kosmop0lit/Pitot_tube_telemetry/media/photo_6_2026-10-28_22-49-24.jpg

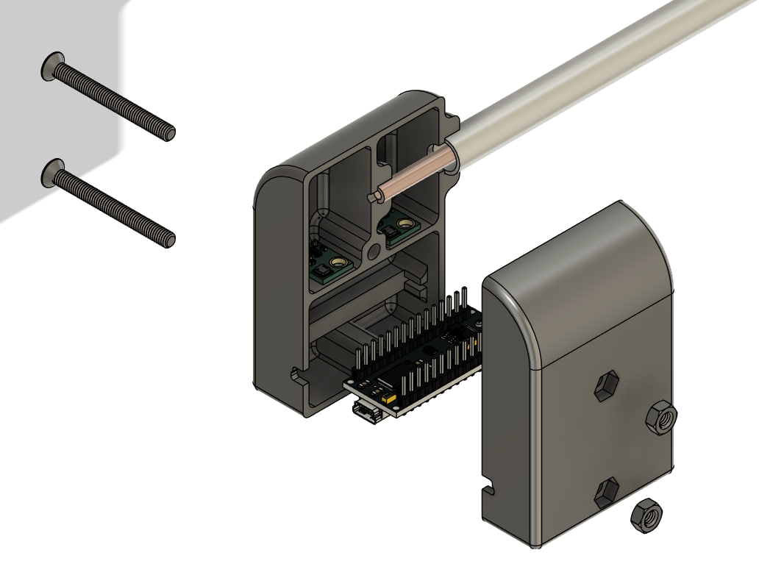
media/photo_6_2026-10-28_22-49-24.jpg
