kosmop0lit/Pitot_tube_telemetry/media/photo_2026-10-09_17-07-50 (1).jpg

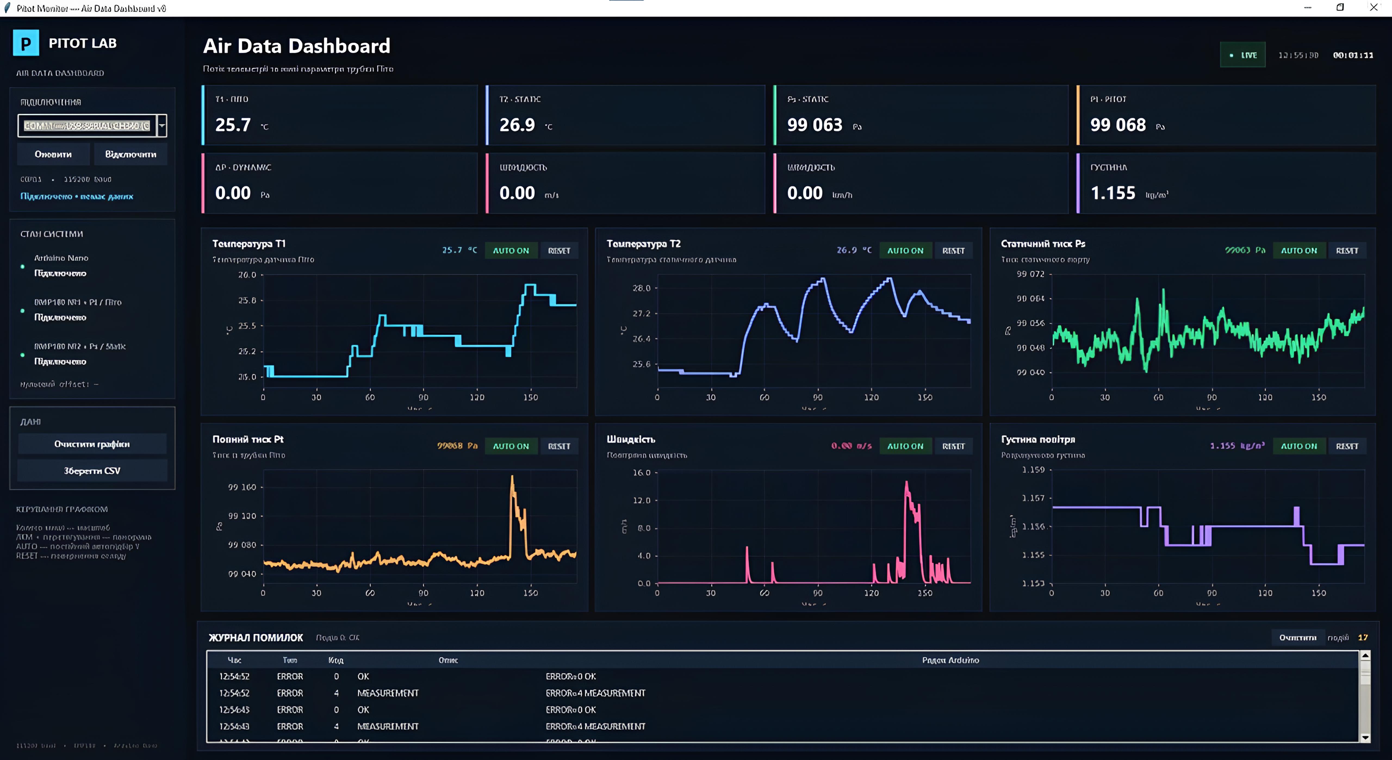
media/photo_2026-10-09_17-07-50 (1).jpg
