kosmop0lit/Pitot_tube_telemetry/media/Анімація.gif

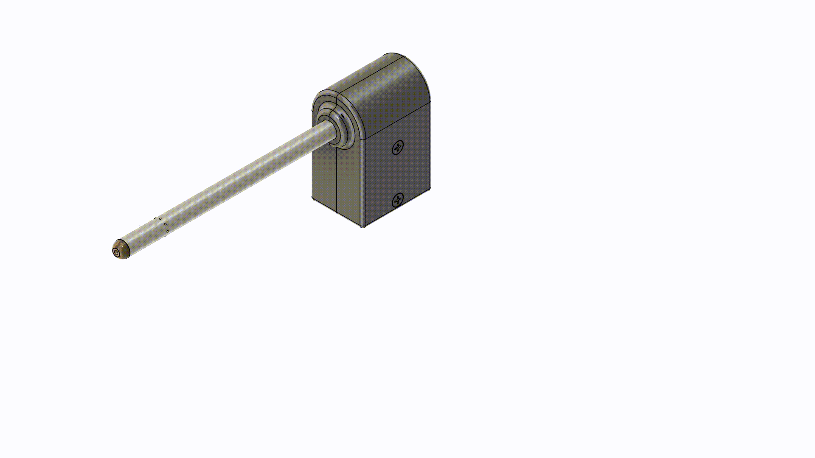
media/Анімація.gif
