kosmop0lit/Pitot_tube_telemetry/schematics/Знімок екрана 2026-10-28 173933.png

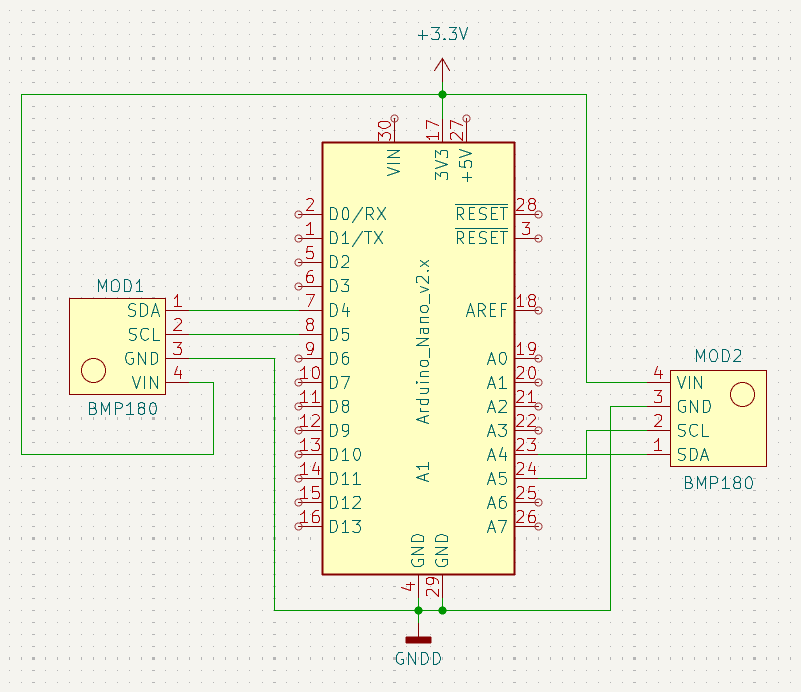
schematics/Знімок екрана 2026-10-28 173933.png
