kosmop0lit/Pitot_tube_telemetry/Pitot_tube_STL.stl

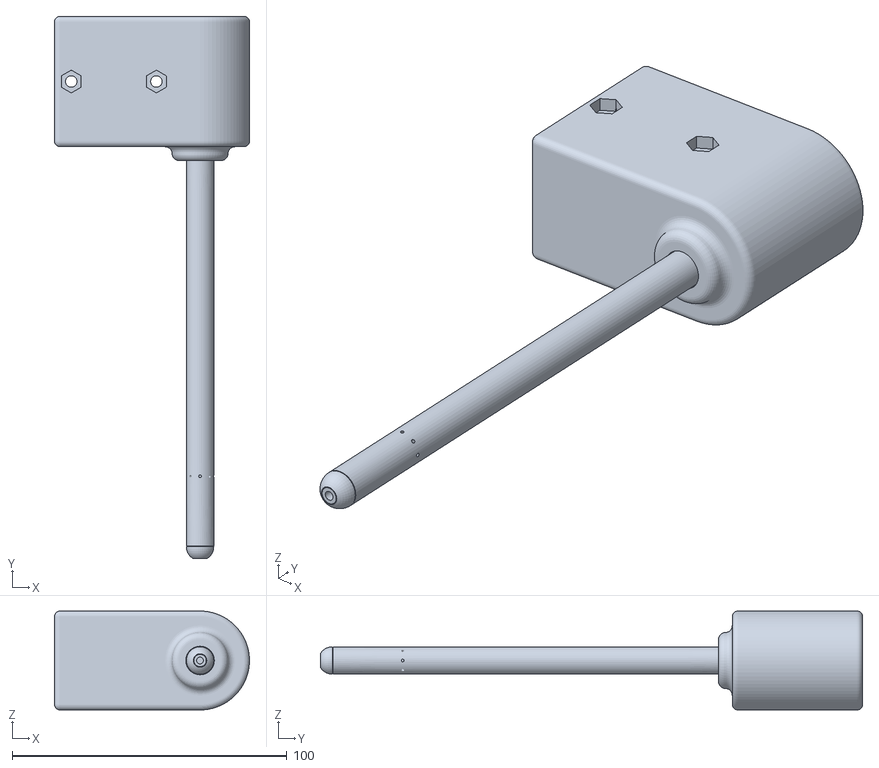
[picture p9: CAD file, 2026-10-28]
Pitot_tube_STL.stl
71.0 x 197.5 x 36.0
