kosmop0lit/Pitot_tube_telemetry/(list of files, cad)

Other CAD files:
Pitot_tube.f3z
